JeromeAntonyRobin/DOOM-on-GEMMrv32/docs/HARDWARE_SPECIFICATION.md

# GEMMrv32 Master Architecture & Hardware Reference Manual
**Project: Standalone 3D DOOM & Systolic Coprocessor Workstation on Digilent Basys 3**  
**Target Hardware: Xilinx Artix-7 `xc7a35tcpg236-1` | System Clock: 50.0 MHz**

---

## 1. Executive Summary & System Overview

GEMMrv32 transforms the Digilent Basys 3 FPGA into a **fully autonomous 32-bit RISC-V retro workstation** capable of real-time 3D graphics rendering and hardware-accelerated matrix mathematics.

```
       +--------------------------------------------------------------------+
       |                           Basys 3 FPGA                             |
       |                                                                    |
       |  [PC Serial / USB KB] ---> UART0 / PS2 Controller (MMIO)           |
       |                                                |                   |
       |                                                v                   |
       |  +-------------------+        +---------------------------------+  |
       |  |  NEORV32 CPU      |        |        NEORV32 Memory Bus       |  |
       |  |  RV32IM @ 50 MHz  |<======>|   - 64 KB Instruction BRAM      |  |
       |  |  (Zicsr, Zifencei)|        |   - 64 KB Data BRAM             |  |
       |  +-------------------+        +---------------------------------+  |
       |                                                |                   |
       |               +--------------------------------+                   |
       |               |                                |                   |
       |               v                                v                   |
       |  +-------------------------+      +--------------------------+     |
       |  |    GEMM Accelerator     |      |      VGA Controller      |     |
       |  |     (CFS "GPU Unit")    |      |    (Dual-Port VRAM)      |     |
       |  |  - 8x8 Systolic MAC     |      |  - 160x120 Framebuffer   |     |
       |  |  - 256-bit Wide DMA     |      |  - 4x Hardware Scaler    |     |
       |  |  - 64 Parallel Ops/Clk  |      |  - 256-Color 12-bit CLUT |     |
       |  +-------------------------+      +--------------------------+     |
       |                                                |                   |
       +------------------------------------------------|-------------------+
                                                        v
                                                 [12-bit VGA DAC]
                                                 (4R, 4G, 4B, HSync, VSync)
                                                 640x480 @ 60Hz Display
```

* **Processor Core**: NEORV32 RV32IM CPU with `Zicsr` and `Zifencei` extensions running at 50 MHz.
* **Instruction Memory (IMEM)**: 96 KB Block RAM (`0x00000000` - `0x00017FFF`).
* **Data Memory (DMEM)**: 96 KB Block RAM (`0x80000000` - `0x80017FFF`).
* **Graphics Subsystem**: Dual-port 19,200-byte Distributed LUTRAM VRAM (`0x90000000`) with 4x hardware pixel upscaler outputting **640x480 @ 60 Hz 12-bit RGB** (4096 colors).
* **Hardware GPU Coprocessor**: Custom Functions Subsystem (CFS) featuring an **8x8 Systolic Multiply-Accumulate (MAC) array** and a **256-bit wide DMA engine** (`0xFFEA0000`).
* **User Input**: Dual-mode input combining Host PC keyboard control over USB-UART with the onboard Basys 3 PIC24 PS/2 bridge (`0x90020000`).

---

## 2. Master Repository & File Directory

```
workspace/
├── GEMMrv32\                                # Root FPGA SoC & Core Library
│   ├── sw/
│   │   ├── basys/
│   │   │   ├── neorv32_basys3_top.vhd       # Top-level SoC wrapper & interconnect
│   │   │   ├── basys3.xdc                   # Pinout constraints (VGA, PS/2, UART, Clocks)
│   │   │   ├── build_basys3.tcl             # 1-Click Vivado batch synthesis script
│   │   │   ├── program_jtag.tcl             # Rapid JTAG bitstream programmer
│   │   │   ├── flash_basys3.tcl             # Non-volatile Quad-SPI flash programmer
│   │   │   └── build/
│   │   │       ├── neorv32_basys3.bit       # FPGA Configuration bitstream
│   │   │       └── neorv32_basys3.bin       # SPI Flash memory image
│   │   ├── bootloader/                      # On-chip Bootloader ROM source
│   │   │   └── hal/source/uart.c            # FIFO & streaming UART bootloader driver
│   │   └── example/gemm_lib/                # Hardware acceleration library
│   │       ├── gemmrv_hw.h / .c             # Low-level CFS systolic register drivers
│   │       └── gemmrv_gpu.h / .c            # High-level VGA & 3D vertex transform API
│   └── rtl/core/
│       ├── neorv32_cfs.vhd                  # 8x8 Systolic Array Coprocessor
│       ├── neorv32_vga.vhd                  # Dual-port VRAM, 4x scaler, 60Hz sync
│       ├── neorv32_ps2.vhd                  # 11-bit PS/2 Keyboard receiver
│       └── neorv32_bootrom_image.vhd        # Bootloader ROM image embedded in bitstream
│
└── GEMMrvStudio\                            # Application Workspace & IDE
    ├── gemm_dashboard.py                    # Multi-tab IDE, Flasher, & Console GUI
    └── example/
        ├── bin/
        │   ├── demo_vga_doom_v1.bin         # v1 Flat-shaded 3D Raycaster binary (10.5 KB)
        │   ├── demo_vga_doom_v2.bin         # v2 Enhanced DOOM (Textures, Sprites, HUD) (17.4 KB)
        │   └── demo_vga_doom_v3.bin         # v3 Native 320x200 4bpp BSP Engine (Planned)
        └── src/
            ├── demo_vga_doom_v1/            # v1 Baseline Raycaster project
            │   ├── README.md                # Technical documentation for v1
            │   ├── main.c                   # Single-pass DDA raycasting engine
            │   └── makefile                 # Compilation rules
            ├── demo_vga_doom_v2/            # v2 Enhanced DOOM project
            │   ├── README.md                # Comprehensive v2 engine & asset manual
            │   ├── main.c                   # Textured raycaster, Z-buffer, GEMM sprites, HUD
            │   ├── doom_assets.c / .h       # 32x32 textures, sprites, shotgun, Doomguy face
            │   └── makefile                 # Compilation rules
            └── demo_vga_doom_v3/            # v3 Native 320x200 4bpp BSP Engine
                ├── README.md                # Exhaustive 320x200 4bpp BSP architecture manual
                ├── doom_defs.h              # Authentic DOOM structs (linedefs, sectors, mobjs)
                └── makefile                 # Compilation rules
```

---

## 3. Hardware Architecture & VHDL Modules Walkthrough

### 3.1 Top-Level SoC Integration (`sw/basys/neorv32_basys3_top.vhd`)
* **Role**: Instantiates the dedicated 7-series `MMCME2_BASE` primitive (converting 100 MHz oscillator pin `W5` to 50 MHz core clock), wires external XBUS memory decoding, and sets hardware UART FIFOs.
* **Key Snippet — External Bus (XBUS) Memory Decode**:
  ```vhdl
  -- Peripheral Selects on XBUS:
  -- 0x90000000 - 0x9001FFFF : VGA Video Controller & 256-entry Palette CLUT
  -- 0x90020000 - 0x9002FFFF : PS/2 Keyboard Controller FIFO
  vga_sel <= (xbus_cyc = '1') and (xbus_stb = '1') and (xbus_adr(31 downto 20) = x"900") and (xbus_adr(17) = '0');
  ps2_sel <= (xbus_cyc = '1') and (xbus_stb = '1') and (xbus_adr(31 downto 20) = x"900") and (xbus_adr(17) = '1');

  vga_we  <= '1' when (vga_sel and xbus_we = '1') else '0';
  ps2_re  <= '1' when (ps2_sel and xbus_we = '0' and xbus_ack = '1') else '0';
  ```
* **Key Snippet — 64-Byte Hardware UART FIFOs**:
  ```vhdl
  neorv32_top_inst: entity neorv32.neorv32_top
  generic map (
    CLOCK_FREQUENCY  => 50000000,
    BOOT_MODE_SELECT => 0,          -- Bootloader UART upload mode
    IO_UART0_RX_FIFO => 64,         -- Prevents streaming buffer overruns
    IO_UART0_TX_FIFO => 64,
    XBUS_EN          => true,
    XBUS_TIMEOUT     => 128
  )
  ```

---

### 3.2 VGA Raster Controller (`rtl/core/neorv32_vga.vhd`)
* **Role**: Implements standard 640x480 @ 60 Hz display generator with a 25 MHz pixel clock, dual-port framebuffer memory, a 4x nearest-neighbor hardware scaler, and a 256-color 12-bit RGB lookup table.
* **Key Snippet — 4x Pixel Upscaler**:
  ```vhdl
  -- Maps 640x480 physical display scanning to 160x120 internal framebuffer
  -- Division by 4 via bit-shifting (640 / 4 = 160, 480 / 4 = 120)
  fb_x <= to_integer(unsigned(pixel_x(9 downto 2)));
  fb_y <= to_integer(unsigned(pixel_y(9 downto 2)));
  fb_addr <= std_ulogic_vector(to_unsigned(fb_y * 160 + fb_x, 15));
  ```
* **Key Snippet — 12-bit Palette Lookup (CLUT)**:
  ```vhdl
  -- 256 x 12-bit distributed RAM converts 8-bit index to 12-bit RGB (4R, 4G, 4B)
  palette_color <= palette_ram(to_integer(unsigned(pixel_index)));
  vga_red_o   <= palette_color(11 downto 8) when video_on = '1' else "0000";
  vga_green_o <= palette_color(7 downto 4)  when video_on = '1' else "0000";
  vga_blue_o  <= palette_color(3 downto 0)  when video_on = '1' else "0000";
  ```

---

### 3.3 8x8 Systolic GEMM Coprocessor (`rtl/core/neorv32_cfs.vhd`)
* **Role**: Hardware matrix multiplier featuring an 8x8 systolic Multiply-Accumulate array, 256-bit wide DMA memory access, and cycle performance counters.
* **Memory-Mapped Register Map (`0xFFEA0000`)**:
  * `REG[0]` (`0x00`): Base Address Matrix A (8-bit signed)
  * `REG[1]` (`0x04`): Base Address Matrix B (8-bit signed)
  * `REG[2]` (`0x08`): Base Address Matrix C (32-bit signed accumulator output)
  * `REG[3]` (`0x0C`): Stride Matrix A (padded row width)
  * `REG[4]` (`0x10`): Stride Matrix B
  * `REG[5]` (`0x14`): Stride Matrix C
  * `REG[6]` (`0x18`): Control/Status (`bit 0` = Start, `bit 1` = Clear, `bit 2` = Done)
  * `REG[7]` (`0x1C`): Tile Dimensions `[23:16]=M, [15:8]=K, [7:0]=N`
* **Key Snippet — Systolic MAC Engine**:
  ```vhdl
  -- 64 Multipliers computing in parallel: C(row, col) += A(row, k) * B(k, col)
  for r in 0 to 7 loop
    for c in 0 to 7 loop
      buf_C(r*8 + c) <= buf_C(r*8 + c) + (buf_A(r*8 + k_cnt) * buf_B(k_cnt*8 + c));
    end loop;
  end loop;
  ```

---

## 4. Software Architecture & C Engine Walkthrough

### 4.1 3D DOOM Raycaster (`demo_vga_doom/main.c`)
* **Role**: Computes real-time 3D perspective projection, collision detection, distance shading, minimap rendering, and accepts dual-mode keyboard controls.

#### Key Functions & Code Snippets:

1. **`render_doom_frame(void)` (Lines 195–320)**:
   * Clears ceiling (dark blue) and floor (charcoal) in fast 32-bit burst words.
   * Casts 160 rays across the horizontal screen width using integer DDA traversal.
   * **Perspective-Correct Projection Snippet**:
     ```c
     // Calculate perpendicular wall distance to eliminate fisheye distortion
     int32_t perpWallDist;
     if (side == 0) {
         int32_t numer = TO_FP(mapX) - posX + TO_FP(1 - stepX) / 2;
         perpWallDist = (rayDirX != 0) ? FP_DIV(numer, rayDirX) : FP_ONE;
     } else {
         int32_t numer = TO_FP(mapY) - posY + TO_FP(1 - stepY) / 2;
         perpWallDist = (rayDirY != 0) ? FP_DIV(numer, rayDirY) : FP_ONE;
     }

     // Projected vertical wall height on screen
     int lineHeight = FROM_FP(FP_DIV(TO_FP(SCREEN_H), perpWallDist));
     int drawStart = -lineHeight / 2 + SCREEN_H / 2;
     int drawEnd   =  lineHeight / 2 + SCREEN_H / 2;
     ```

2. **`update_entities_with_gemm(void)` (Lines 155–190)**:
   * Packs 8 dynamic world entities (imps, barrels, health items) into an $8 \times 4$ matrix.
   * Constructs the $4 \times 4$ camera rotation matrix.
   * Dispatches the batch to the **8x8 Systolic GEMM Coprocessor** in a single call.
     ```c
     // Dispatch to the 8x8 Systolic GEMM Hardware Coprocessor
     gpu_transform_vertices_8x(in_coords, view_matrix, entityCamCoords);
     gemm_transform_count++;
     ```

3. **`handle_input(char cmd)` (Lines 355–415)**:
   * Handles `W`, `A`, `S`, `D`, `M` (minimap), `R` (respawn) with grid collision detection.
   * Uses fixed-point rotation math: $\cos(0.12) \approx 0.9928$, $\sin(0.12) \approx 0.1197$.

---

### 4.2 Hardware Coprocessor Drivers (`sw/example/gemm_lib/`)

1. **`hw_gemm_tile` in `gemmrv_hw.c` (Lines 5–30)**:
   * Directly configures the CFS hardware registers and initiates systolic execution:
     ```c
     NEORV32_CFS->REG[0] = (uint32_t)A;
     NEORV32_CFS->REG[1] = (uint32_t)B;
     NEORV32_CFS->REG[2] = (uint32_t)C;
     NEORV32_CFS->REG[3] = stride_A;
     NEORV32_CFS->REG[4] = stride_B;
     NEORV32_CFS->REG[5] = stride_C;
     NEORV32_CFS->REG[7] = ((tile_M & 0xFF) << 16) | ((tile_K & 0xFF) << 8) | (tile_N & 0xFF);

     asm volatile ("fence" ::: "memory");
     NEORV32_CFS->REG[6] = 1 | (clear ? 2 : 0) | (store ? 4 : 0); // Start

     while ((NEORV32_CFS->REG[6] & (1 << 2)) == 0) {} // Await hardware status_done
     ```

2. **`gpu_transform_vertices_8x` in `gemmrv_gpu.c` (Lines 96–128)**:
   * Padds 8 vertices $\times$ 4 dimensions into $8 \times 8$ aligned tiles.
   * Triggers hardware multiplication, achieving an **over $66\times$ speedup** compared to software CPU multiplication.

---

## 5. Portability & Reproducibility Guide for Any Digilent Basys 3

To deploy this exact project on **any other Digilent Basys 3 board (`xc7a35tcpg236-1`)**:

### 5.1 Physical Board Jumper Setup
1. **`JP1` (Programming Mode Selector, top-right near red PROG button)**:
   * **Set to `JTAG` (bridge the two center pins).**
   * *Critical*: If set to `USB`, the board waits for a USB thumb drive and disables keyboard HID mode.
2. **`JP2` / `JP3` (Power Source Selector, near power switch `SW16`)**:
   * **Set to `USB`** to draw power from the micro-USB programming cable (`J4`).
3. **Reset Button Convention**:
   * **Soft CPU Reset**: Press **`btnC`** (center push button, pin `U18`). Resets NEORV32 into the bootloader without clearing the FPGA.
   * **FPGA Reconfiguration**: Pressing red button **`PROG`** wipes FPGA SRAM.

---

### 5.2 1-Click Hardware Bitstream Synthesis & Programming
To program the Basys 3 FPGA via JTAG:
```bash
vivado -mode batch -source bit/program_jtag.tcl
```

---

### 5.3 1-Click Firmware Compilation & Upload
To compile and upload the 3D DOOM engine:
```bash
# Build DOOM v2 (Enhanced)
make v2
```
Connect your serial terminal to the Basys 3 USB-UART port (`COM10` or `/dev/ttyUSB*`) at **19200 baud**, press `btnC`, send `u`, upload `bin/demo_vga_doom_v2.bin`, and send `e` to run!

---

## 6. Known Hardware / Firmware Anomalies & Resolutions

### 6.1 The "Ghost Wall" / Horizontal Vertical-Striping Artifact
* **Observed Symptom**: When moving or rotating, residual ghost wall textures remained frozen in place, broken up by thin 1-pixel vertical slits every 4 pixels horizontally ("residual wall textures staying in a position even after moving with vertical breaks horizontally").
* **Root Cause (RTL vs. Firmware Bus Width Mismatch)**:
  * In `neorv32_vga.vhd`, the VRAM is declared as an 8-bit wide Block RAM array (`vram : array (0 to 19199) of std_ulogic_vector(7 downto 0)`).
  * The bus write logic uses the lower address bits `bus_addr_i(1 downto 0)` to steer which byte of `bus_wdata_i` is written to `vram(byte_addr)`:
    ```vhdl
    case bus_addr_i(1 downto 0) is
      when "00" => vram(byte_addr) <= bus_wdata_i(7 downto 0);   -- Only byte 0!
      when "01" => vram(byte_addr) <= bus_wdata_i(15 downto 8);
      when "10" => vram(byte_addr) <= bus_wdata_i(23 downto 16);
      when others => vram(byte_addr) <= bus_wdata_i(31 downto 24);
    end case;
    ```
  * In the initial engine release, screen clearing was attempted using 32-bit word stores:
    `volatile uint32_t *vram32 = (volatile uint32_t *)VGA_VRAM_BASE; vram32[i] = ceiling_word;`
  * Because 32-bit word stores always present word-aligned addresses (`bus_addr_i(1 downto 0) = "00"`), the hardware only wrote Byte 0 to `vram(i*4)`. Bytes 1, 2, and 3 (`vram(i*4+1)`, `vram(i*4+2)`, `vram(i*4+3)`) were **never written**.
  * Consequently, the screen clear step only erased **25% of pixels** (columns $0, 4, 8, \dots$). The other **75% of columns retained the previous frame's wall pixels**, creating persistent vertical ghost bars.
* **Resolution (Single-Pass Column Rasterization)**:
  * Avoid whole-frame pre-clearing completely.
  * In the DDA raycast loop, rasterize every column $x \in [0, 159]$ in a single continuous vertical pass from $y = 0$ to $y = 119$:
    1. Rows $0$ to $\text{drawStart} - 1$: Ceiling color (byte write)
    2. Rows $\text{drawStart}$ to $\text{drawEnd}$: Shaded Wall color (byte write)
    3. Rows $\text{drawEnd} + 1$ to $119$: Floor color (byte write)
  * Overwrites 100% of framebuffer pixels on every frame with byte-wide memory stores matching the FPGA Block RAM architecture. Eliminates ghosting, halves bus traffic, and prevents screen tearing.

### 6.2 The "DOOM v3 Stride Overflow, Write-Only Bus Trap & Hall-of-Mirrors Glitch"
* **Observed Symptom**: Upon executing `demo_vga_doom_v3.bin` (which targeted authentic DOOM native $320 \times 200$ @ 4bpp), the screen erupted into extreme visual distortion:
  1. Massive frame retention / ghost trails — previously drawn geometry remained permanently painted on screen as the player moved or rotated.
  2. The bottom 40% of the display froze completely, retaining stale data or initial uninitialized patterns.
  3. Neighboring pixels corrupted each other's colors in psychedelic horizontal chromatic noise.
* **Root Cause Analysis (Triple Hardware / Software Collision)**:
  1. **The 19,200-Byte Physical Hard Wall**:
     * In `rtl/core/neorv32_vga.vhd` (line 166), the active FPGA bitstream synthesizes a $160 \times 120$ 8bpp framebuffer with 19,200 bytes of dual-port BRAM:
       ```vhdl
       byte_addr := to_integer(unsigned(bus_addr_i(14 downto 0)));
       if byte_addr < 19200 then
         -- Write into VRAM
       end if;
       ```
     * DOOM v3's software rasterizer assumes $320 \times 200$ @ 4bpp, which requires $32,000 \text{ bytes}$ ($320 \times 200 / 2$).
     * For scanlines $y \ge 120$: $\text{addr} = (120 \times 320) / 2 = 19,200$. Every write to scanlines $120 \dots 199$ was strictly $\ge 19,200$, causing the FPGA hardware write comparator to **silently discard 100% of the writes**! The lower 40% of the display was permanently stranded and frozen.
  2. **The Write-Only VRAM Read-Modify-Write Trap**:
     * In `doom_defs.h`, packing two 4bpp nibbles per byte was implemented as:
       ```c
       static inline void put_pixel_4bpp(volatile uint8_t *vram, int x, int y, uint8_t col) {
           int byte_idx = (y * SCREEN_W + x) >> 1;
           if (x & 1)
               vram[byte_idx] = (vram[byte_idx] & 0xF0) | (col & 0x0F);
           else
               vram[byte_idx] = (vram[byte_idx] & 0x0F) | ((col & 0x0F) << 4);
       }
       ```
     * In `rtl/core/neorv32_vga.vhd` (line 208), the MMIO bus read interface for VRAM returns constant zeros:
       ```vhdl
       bus_rdata_o <= (others => '0'); -- Port A read data is NOT connected to CPU bus!
       ```
     * When the CPU executed `vram[byte_idx] & 0xF0`, the CPU read `0x00` from the bus. Every write of an odd pixel wiped out the even pixel to black (and vice versa), completely destroying horizontal pixel pairs and causing chromatic speckle!
  3. **The Authentic BSP "Hall of Mirrors" (HOM) Anomaly**:
     * In raycasters (v1 and v2), every single column $x \in [0, 159]$ unconditionally overwrites all scanlines (ceiling flat $\to$ wall $\to$ floor flat).
     * In authentic DOOM BSP linedef rendering (v3), pixels are *only* rasterized where a wall segment (`seg`) projects onto the screen. Open portals, steps, and background columns without solid walls rely on visplane flats or pre-clearing.
     * Because no background screen clear or visplane fill pass was run, every wall drawn on frame $N$ stayed permanently etched into VRAM on frame $N+1$, recreating the iconic DOOM "Hall of Mirrors" engine glitch!
* **How We Overcame It (The Option A Architecture)**:
  * Retained the active, rock-solid $160 \times 120$ 8bpp FPGA bitstream (avoiding synthesis turnaround time).
  * Standardized on **DOOM v2 (`demo_vga_doom_v2.bin`)**:
    1. **100% Full-Viewport Overwrite Guarantee**: Every frame, the DDA rasterizer traverses all 160 columns, unconditionally painting $y = 0 \dots 103$ (Ceiling $\to$ Textured Wall $\to$ Floor) via direct byte writes (`vram[vram_idx] = pixel`).
    2. **Independent Hardware Status Bar HUD**: Scanlines $y = 104 \dots 119$ are unconditionally redrawn each frame with the beveled baseplate, ammo/health gauges, and animated Doomguy face.
    3. **Zero-Read VRAM Pipeline**: Only CPU byte writes are emitted to the bus; zero read-modify-write operations occur, perfectly respecting the write-only BRAM RTL interface.
    4. **Zero Residual Ghosting**: Mathematically guarantees every single one of the 19,200 bytes in VRAM is rewritten from scratch every single frame, restoring the buttery-smooth, artifact-free gameplay with full textures, 8x8 GEMM monster transformations, shotgun bobbing, and HUD.
