JeromeAntonyRobin/DOOM-on-GEMMrv32/docs/FRAME_RETENTION_AND_BUFFER_STALL_RESOLUTION.md

# Zero-Retention Column Rasterization & Buffer Stall Resolution

## 1. Executive Summary

During testing of the native $320 \times 200$ Mode 13h bare-metal DOOM 2 port on the Digilent Basys 3 FPGA (`xc7a35t`), severe frame retention, weapon ghosting, frozen muzzle flashes, and buffer stalls were observed.

This report documents the root cause analysis, the architectural solution implemented in the renderer, and the live hardware verification confirming continuous, fluid, zero-retention gameplay.

---

## 2. Root Cause Analysis

Four distinct hardware/software interactions combined to create the perceived frame retention and buffer issues:

### 2.1 The Blocking UART Trap (`neorv32_uart0_available`)
In `main.c`, the main game loop polled keyboard commands using:
```c
if (neorv32_uart0_available()) {
    char cmd = (char)neorv32_uart0_getc();
    handle_input(cmd);
}
```
In the NEORV32 software runtime (`sw/lib/source/neorv32_uart.c`):
- `neorv32_uart_available()` checks if the UART peripheral was **synthesized into the SoC netlist** (`SYSINFO_SOC_IO_UART0`). It returns `1` permanently.
- `neorv32_uart_getc()` is explicitly **blocking**:
  ```c
  char neorv32_uart_getc(neorv32_uart_t *UARTx) {
      while (neorv32_uart_char_received(UARTx) == 0); // wait until data available
      return neorv32_uart_char_received_get(UARTx);
  }
  ```
Because `neorv32_uart0_available()` was always true, `neorv32_uart0_getc()` was invoked on every single frame, **blocking CPU execution indefinitely until the user pressed a key**. The engine was completely frozen when idle, rendering only 1 frame per keystroke and retaining old frames permanently.

### 2.2 VRAM 32-Bit Word Store Truncation
In `rtl/core/neorv32_vga.vhd` (line 220), the dual-port Block RAM write interface is byte-wide:
```vhdl
if bus_we_i = '1' and bus_addr_i(16) = '0' then
    byte_addr_w := to_integer(unsigned(bus_addr_i(15 downto 0)));
    if byte_addr_w < 64000 then
        case bus_addr_i(1 downto 0) is
            when "00"   => vram(byte_addr_w) <= bus_wdata_i(7 downto 0);
            when "01"   => vram(byte_addr_w) <= bus_wdata_i(15 downto 8);
            when "10"   => vram(byte_addr_w) <= bus_wdata_i(23 downto 16);
            when others => vram(byte_addr_w) <= bus_wdata_i(31 downto 24);
        end case;
    end if;
end if;
```
Any 32-bit word store (`sw` instruction or standard `memset`) writes only to `bus_addr_i(1..0) == "00"`, **dropping 3 out of every 4 bytes**. When earlier attempts tried to clear the screen using 32-bit word stores, 75% of pixel columns were never wiped, creating comb-like retention artifacts.

### 2.3 Phantom VBlank Spin Delay
`wait_for_vblank()` polled `VGA_STATUS_REG` (`0x90010400`). On the XC7A35T single-buffered bitstream, sampling `0x90010400` 100,000 times returned `0x00000000` constantly. The timeout loop was spinning for 500,000 cycles (~110 ms) on every single frame, artificially throttling the engine down to 8 FPS and causing huge stutter gaps.

### 2.4 Unoccluded Column Apertures
In single-buffered Mode 13h without a double buffer, clearing the entire 53,760-byte viewport at the start of a frame causes severe flicker because the VGA raster beam scans the memory while it is blank. Conversely, without clearing, columns that do not intersect a solid wall retained previous frame pixels (such as moving Imps, bobbing weapons, or muzzle flashes).

---

## 3. The Solution: Zero-Retention 100% Column Rasterization

To eliminate both frame retention and buffer flicker without requiring a double buffer (which cannot fit in the Basys 3's 50 BRAM tiles), the Id Software single-pass column coverage model was implemented:

```
+-------------------------------------------------------------+
| Viewport Scanlines (y = 0 .. 167)                           |
|                                                             |
|   1. R_RenderBSPNode(0)                                     |
|      - One-sided solid walls: draws ceiling, STARTAN3, floor|
|      - Two-sided portals: draws steps, updates clip arrays  |
|                                                             |
|   2. R_FillBackdrop()                                       |
|      - For any column x with ceilingclip[x] < floorclip[x]: |
|        * y = ceilingclip[x]+1 .. 83: Tech Blue Ceiling (112)|
|        * y = 84 .. floorclip[x]-1: Stone Floor Flat (72)    |
|      ==> 100% OF ALL 53,760 VIEWPORT PIXELS OVERWRITTEN!    |
|                                                             |
|   3. R_DrawMasked() (Imps, Barrels, Fireballs via GEMM)     |
|   4. render_weapon() (Super Shotgun + dynamic muzzle flash) |
+-------------------------------------------------------------+
| Status Bar Scanlines (y = 168 .. 199)                       |
|   5. render_status_bar()                                    |
|      - Grey bevel plate, Doomguy face, Ammo bar, Health bar |
|      ==> 100% OF ALL 10,240 HUD PIXELS OVERWRITTEN!         |
+-------------------------------------------------------------+
```

### 3.1 `R_FillBackdrop()` Implementation (`src/v4/r_segs.c`)
```c
void R_FillBackdrop(void) {
    volatile uint8_t *vram = (volatile uint8_t *)VGA_VRAM_BASE;

    for (int x = 0; x < SCREEN_W; x++) {
        int c_top = ceilingclip[x];
        int f_bot = floorclip[x];

        if (c_top < f_bot) {
            // Fill unoccluded ceiling above horizon (CENTER_Y = 84)
            int y_end_ceil = (f_bot < CENTER_Y) ? f_bot : CENTER_Y;
            for (int y = c_top + 1; y < y_end_ceil; y++) {
                vram[y * SCREEN_W + x] = 112; // Authentic tech blue ceiling
            }

            // Fill unoccluded floor below horizon down to f_bot
            int y_start_floor = (c_top + 1 > CENTER_Y) ? (c_top + 1) : CENTER_Y;
            for (int y = y_start_floor; y < f_bot; y++) {
                vram[y * SCREEN_W + x] = 72;  // Authentic brown stone floor flat
            }
        }
    }
}
```

### 3.2 Non-Blocking Input Loop (`src/v4/main.c`)
```c
while (1) {
    // Poll UART0 (PC Keyboard) - Non-blocking FIFO check!
    if (neorv32_uart0_char_received()) {
        char cmd = neorv32_uart0_char_received_get();
        handle_input(cmd);
    }

    // Poll PS/2 Keyboard Port - Non-blocking!
    if (*((volatile uint32_t *)PS2_STAT_REG) & 1) {
        uint8_t sc = (uint8_t)(*((volatile uint32_t *)PS2_DATA_REG) & 0xFF);
        char ch = ps2_scancode_to_ascii(sc);
        if (ch) handle_input(ch);
    }

    // Advance 35 Hz Monster AI & Projectile physics
    P_Ticker();

    // Render Frame continuously for fluid, retention-free gameplay
    render_doom_v3_frame();
    if (muzzle_flash > 0) muzzle_flash--;
}
```

---

## 4. Hardware Verification & Results

1. **Continuous Autonomy**: The engine was flashed to Digilent Basys 3 over `COM10` at 19,200 baud. The main loop ran uninterrupted, advancing beyond Frame 250 with continuous real-time telemetry streaming.
2. **Zero Retention**: Moving the camera (`w`, `s`, `a`, `d`), weapon bobbing, and firing the Super Shotgun (`SPACE`) confirmed:
   - Zero ghosting behind walking Imps.
   - Zero lingering buckshot or muzzle flash pixels.
   - Clean Doomguy face updates on the status bar.
3. **GEMM Coprocessor Utilization**: 1:1 hardware batch processing across all rendered frames without stalling.
