JeromeAntonyRobin/DOOM-on-GEMMrv32/sw/basys/clockInfo.txt

-------------------------------------
| Tool Version : Vivado v.2025.2
| Date         : Wed Oct 14 12:19:21 2026
| Host         : Eathes
| Design       : design_1
| Device       : xc7a35t-cpg236-1--
-------------------------------------

For more information on clockInfo.txt clock routing debug file see https://support.xilinx.com/s/article/000035660?language=en_US
