JeromeAntonyRobin/DOOM-on-GEMMrv32/docs/figures/gemm_architecture.png

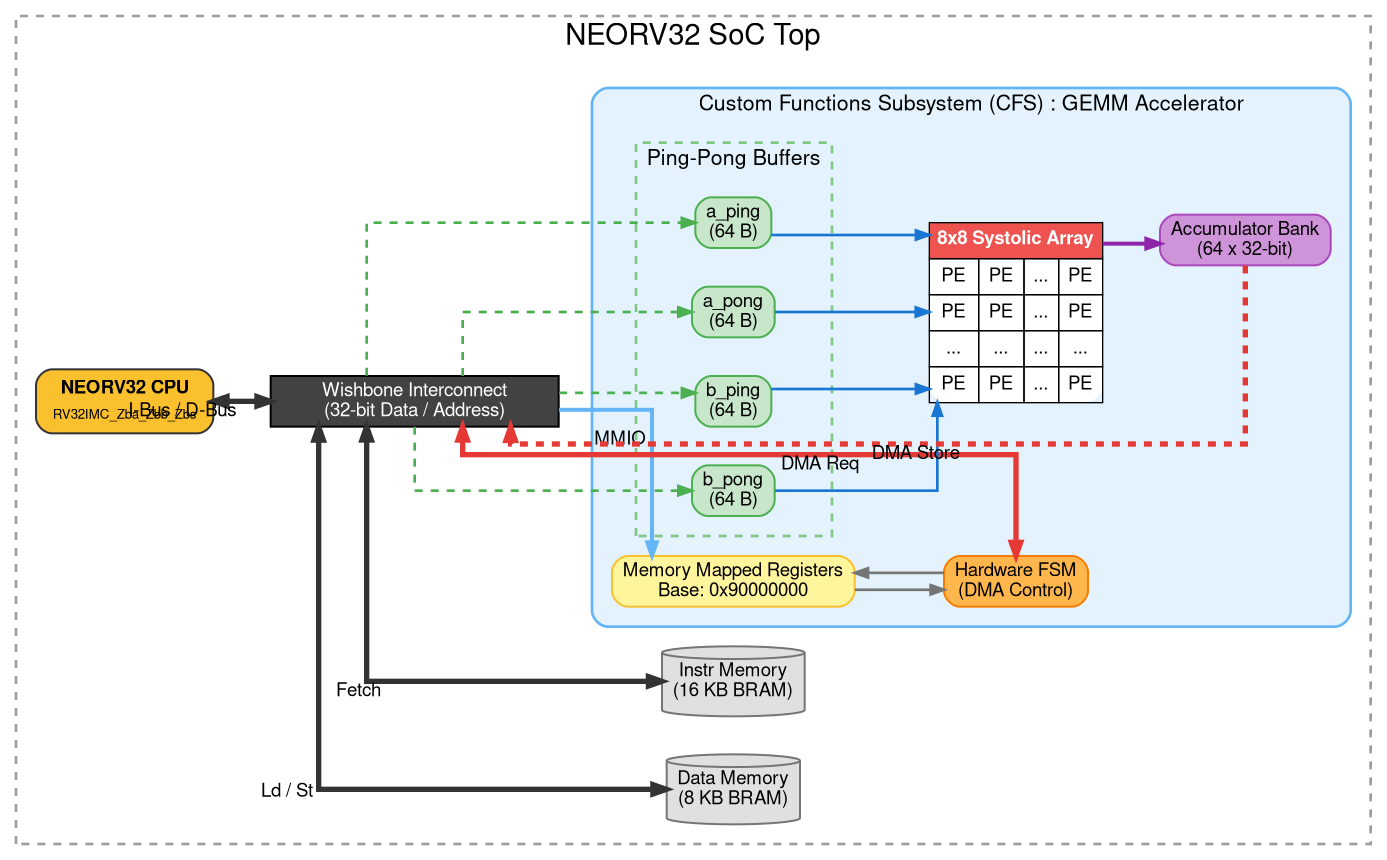
docs/figures/gemm_architecture.png
