JeromeAntonyRobin/DOOM-on-GEMMrv32/docs/AUTHENTIC_RENDERING_PIPELINE_FIXES.md

# Authentic DOOM 2 Rendering Pipeline Resolution on GEMMrv32

## Executive Summary
This document records the comprehensive architectural investigation and fixes implemented to eliminate visual rendering issues in the bare-metal authentic DOOM 2 engine running on the Digilent Basys 3 FPGA (`xc7a35t`).

The engine runs at **native 320x200 @ 8bpp Mode 13h** using an on-chip Block RAM single framebuffer and an authentic 256-color 12-bit RGB palette extracted directly from Id Software's `DOOM2.WAD`.

---

## 1. Root Cause Analyses & Technical Solutions

### 1.1 The Two-Sided Portal Floor Retention Gap
- **Symptom**: Massive frame retention, sprite trails, and frozen weapon ghosts across the bottom-center scanlines ($y = 117..167$) when facing doorways or stairs.
- **Root Cause**:
  In `r_segs.c`, two-sided portals (such as the stair step on Line 2) rasterized only the step face and adjusted `floorclip[x] = y_b_floor`. When distant solid walls (such as the courtyard wall on Line 6) were subsequently rasterized, they only drew pixels up to `floorclip[x]` and then set `floorclip[x] = -1` to mark the column occluded. The floor area in front of the step ($y = 117..167$) was **never drawn** by the portal, **never drawn** by the distant wall, and skipped by post-backdrop fill logic because `floorclip[x]` was $-1$. Consequently, any pixels written by the weapon sprite or walking monsters in that aperture remained permanently in VRAM.
- **Solution**:
  Implemented `R_ClearBackdrop()`, which performs a fast linear fill of the top 84 lines with authentic tech blue ceiling flat (index `112`) and the bottom 84 lines with brown stone floor flat (index `72`) before any geometry traversal. This guarantees 100% clean background pixel coverage every frame without requiring a black pre-wipe.

### 1.2 BSP Subsector Traversal Line Decoupling
- **Symptom**: Inverted occlusion where far walls overwrote near walls depending on player angle, coupled with quadruple rendering overhead.
- **Root Cause**:
  `R_Subsector(num)` in `r_bsp.c` previously looped across all linedefs in the map regardless of `num`. Every subsector traversed by the recursive BSP walk re-evaluated all linedefs in fixed array index order ($0..11$), bypassing BSP front-to-back sorting and wasting CPU time.
- **Solution**:
  Defined explicit subsector linedef partitions:
  - Subsector 0 (Starting Hangar): Lines `{0, 1, 2}`
  - Subsector 1 (Stairs & West Courtyard): Lines `{3, 5, 6, 7}`
  - Subsector 2 (Stairs & East Courtyard): Lines `{4, 5, 7, 8}`
  - Subsector 3 (Computer Terminal Room): Lines `{9, 10, 11}`
  Integrated a per-frame `line_rendered[NUM_LINES]` bitmask reset by `R_ClearClipSegs()`. Lines are now rasterized strictly in true front-to-back order, with zero redundant processing.

### 1.3 Open Portal Depth Occlusion of Monsters
- **Symptom**: Imp demons standing in the stairway or courtyard were either completely invisible or sliced in half.
- **Root Cause**:
  In `r_segs.c`, two-sided walls were updating `wall_dist_buffer[x] = tz`. Because `wall_dist_buffer` is a 1D column buffer, storing the portal's distance caused `R_DrawMasked()` to treat the open doorway as an opaque wall, rejecting any monster positioned behind the doorway.
- **Solution**:
  Updated two-sided portal logic to never overwrite `wall_dist_buffer[x]`. Only solid, one-sided walls write to `wall_dist_buffer[x]`, allowing monsters in adjacent rooms to remain fully visible through doorways.

### 1.4 Gap-Free Sprite Scaler Precision & Bounds
- **Symptom**: Monster billboards exhibited horizontal scanline gaps ("Venetian-blind" effect) and occasional CPU hangs when walking close to enemies.
- **Root Cause**:
  `draw_authentic_patch_scaled()` in `doom_assets_authentic.c` clamped `dest_y0` and `dest_y1` to screen bounds *before* computing the denominator `post_h = dest_y1 - dest_y0`. When an entity was clipped by the viewport edge, `post_h` shrank, accelerating texture sampling and causing divide-by-zero or out-of-bounds reads.
- **Solution**:
  Calculated `raw_post_h = raw_dest_y1 - raw_dest_y0` using unclamped projections. Enforced `raw_post_h > 0` before clamping screen bounds `dest_y0` and `dest_y1`, and continuously interpolated scanlines via `((dy - raw_dest_y0) * length) / raw_post_h`.

### 1.5 Authentic DOOM 2 Monster Spawning
- **Symptom**: Barrels and medkits appeared as squished Imp demon sprites.
- **Root Cause**:
  `R_DrawMasked()` defaulted to `patch_trooa1` for non-monster entities.
- **Solution**:
  Updated `map_spawns` in `doom_map.h` to spawn genuine DOOM 2 enemies with their extracted Id Software WAD patches:
  - Imp Demon (`MT_IMP` with `patch_trooa1`) at the top of the stairs.
  - Pinky Demon (`MT_DEMON` with `patch_sarga1`) roaming the toxic courtyard.
  - Shotgun Guy (`MT_SHOTGUNGUY` with `patch_sposa1`) guarding the computer terminal room.
  Filtered out non-monster types in `p_mobj.c` so only authentic sprites are rendered.

---

## 2. Verification & Live Hardware Status
- **Target Hardware**: Digilent Basys 3 FPGA (`xc7a35t`, target `210183BE9DFDA`).
- **UART Port**: `COM10` @ 19,200 baud.
- **Frame Rate & Stability**: Continuous telemetry verified past 120+ frames (`[DOOM 2] Frame: 120 | GEMM Batches: 120 | Health: 100 | Ammo: 48`).
- **Weapon & AI**: Super Shotgun fires 20 buckshot pellets with twin muzzle flash, inflicting 120 damage and eliminating monsters in real time.
