JeromeAntonyRobin/DOOM-on-GEMMrv32/rtl/core/neorv32_bootrom_image.vhd

library ieee;
use ieee.std_logic_1164.all;

package neorv32_bootrom_image is

type rom_t is array (0 to 2047) of std_ulogic_vector(31 downto 0);
constant image_size_c : natural := 4272;
constant image_data_c : rom_t := (
x"f14020f3",
x"80200217",
x"0fc20213",
x"ff027113",
x"80200197",
x"7f018193",
x"000022b7",
x"80028293",
x"30029073",
x"00000317",
x"13030313",
x"30531073",
x"30401073",
x"00001397",
x"05438393",
x"80200417",
x"fc440413",
x"80200497",
x"fc048493",
x"80200517",
x"fb850513",
x"80200597",
x"fbc58593",
x"00000613",
x"00000693",
x"00000713",
x"00000793",
x"00000813",
x"00000893",
x"00000913",
x"00000993",
x"00000a13",
x"00000a93",
x"00000b13",
x"00000b93",
x"00000c13",
x"00000c93",
x"00000d13",
x"00000d93",
x"00000e13",
x"00000e93",
x"00000f13",
x"00000f93",
x"04008463",
x"00000797",
x"01c78793",
x"30579073",
x"30445073",
x"30046073",
x"10500073",
x"ffdff06f",
x"00000797",
x"08878793",
x"30579073",
x"30405073",
x"fff44737",
x"00872103",
x"00c72603",
x"fff40737",
x"00072223",
x"0380006f",
x"00838e63",
x"00947c63",
x"0003a783",
x"00f42023",
x"00438393",
x"00440413",
x"fe9468e3",
x"00b57863",
x"00052023",
x"00450513",
x"feb56ce3",
x"00000617",
x"79860613",
x"0ff0000f",
x"0000100f",
x"00000513",
x"00000593",
x"000600e7",
x"30047073",
x"30401073",
x"00000597",
x"01058593",
x"30559073",
x"34051073",
x"10500073",
x"ffdff06f",
x"fffe07b7",
x"0087a783",
x"00000513",
x"00e79713",
x"00075e63",
x"fff507b7",
x"0007a703",
x"00f71693",
x"fe06dce3",
x"0047a503",
x"0ff57513",
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
x"01010113",
x"00012d03",
x"00412c83",
x"00812c03",
x"00c12b83",
x"01010113",
x"00012b03",
x"00412a83",
x"00812a03",
x"00c12983",
x"01010113",
x"00012903",
x"00412483",
x"00812403",
x"00c12083",
x"01010113",
x"00008067",
x"52524507",
x"445f524f",
x"43495645",
x"00000a45",
x"00000000",
x"52524507",
x"535f524f",
x"414e4749",
x"45525554",
x"0000000a",
x"52524507",
x"435f524f",
x"4b434548",
x"0a4d5553",
x"00000000",
x"000a4b4f",
x"5b1b070a",
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
x"79ca1a27",
x"740f360c",
x"8051f1ad",
others => (others => '0')
);

end package;
