JeromeAntonyRobin/DOOM-on-GEMMrv32/rtl/core/neorv32_imem_image.vhd

library ieee;
use ieee.std_logic_1164.all;

package neorv32_imem_image is

type rom_t is array (0 to 8191) of std_ulogic_vector(31 downto 0);
constant image_size_c : natural := 32768;
constant image_data_c : rom_t := (
x"f14020f3",
x"80010217",
x"ffc20213",
x"ff027113",
x"80000197",
x"7f018193",
x"000022b7",
x"80028293",
x"30029073",
x"00000317",
x"19430313",
x"30531073",
x"30401073",
x"00001397",
x"f4838393",
x"80000417",
x"fc440413",
x"80000497",
x"fbc48493",
x"80000517",
x"fb450513",
x"80000597",
x"fac58593",
x"00000613",
x"00000693",
x"00000713",
x"00000793",
x"00000813",
x"00000893",
x"00000913",
x"00000993",
x"00000a13",
x"00000a93",
x"00000b13",
x"00000b93",
x"00000c13",
x"00000c93",
x"00000d13",
x"00000d93",
x"00000e13",
x"00000e93",
x"00000f13",
x"00000f93",
x"04008463",
x"00000797",
x"01c78793",
x"30579073",
x"30445073",
x"30046073",
x"10500073",
x"ffdff06f",
x"00000797",
x"0ec78793",
x"30579073",
x"30405073",
x"fff44737",
x"00872103",
x"00c72603",
x"fff40737",
x"00072223",
x"05c0006f",
x"00838e63",
x"00947c63",
x"0003a783",
x"00f42023",
x"00438393",
x"00440413",
x"fe9468e3",
x"00b57863",
x"00052023",
x"00450513",
x"feb56ce3",
x"00001417",
x"b9040413",
x"00001497",
x"b8848493",
x"00947a63",
x"00042083",
x"000080e7",
x"00440413",
x"fe946ae3",
x"00000617",
x"21860613",
x"0ff0000f",
x"0000100f",
x"00000513",
x"00000593",
x"000600e7",
x"30047073",
x"30401073",
x"00000597",
x"05058593",
x"30559073",
x"34051073",
x"f1402473",
x"02041463",
x"00001417",
x"b3040413",
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
x"00000000",
x"00000000",
x"00000000",
x"00000000",
x"00000000",
x"00000000",
x"00000000",
x"00000000",
x"00000000",
x"00000000",
x"00000000",
x"00000000",
x"00000000",
x"00000000",
x"00000000",
x"00000000",
x"00000000",
x"00000000",
x"00000000",
x"00000000",
x"00000000",
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
);

end package;
