JeromeAntonyRobin/DOOM-on-GEMMrv32/rtl/core/neorv32_prim.vhd

-- ================================================================================ --
-- NEORV32 Primitives - Generic Single-Clock FIFO (FIFO)                            --
-- -------------------------------------------------------------------------------- --
-- The FIFO operates in "first-word-fall-through" (FWFT) mode: the first written    --
-- word appears directly at the output (after the optional synchronous-read delay)  --
-- without any explicit read access.                                                --
-- -------------------------------------------------------------------------------- --
-- The NEORV32 RISC-V Processor - https://github.com/stnolting/neorv32              --
-- Copyright (c) NEORV32 contributors.                                              --
-- Copyright (c) 2020 - 2026 Stephan Nolting. All rights reserved.                  --
-- Licensed under the BSD-3-Clause license, see LICENSE for details.                --
-- SPDX-License-Identifier: BSD-3-Clause                                            --
-- ================================================================================ --

library ieee;
use ieee.std_logic_1164.all;
use ieee.numeric_std.all;

entity neorv32_prim_fifo is
  generic (
    AWIDTH  : natural; -- address width (= log2(number of FIFO entries))
    DWIDTH  : natural; -- size of data elements in FIFO
    OUTGATE : boolean; -- true = output zero if no data available
    ASYNCRD : boolean  -- true = asynchronous read, false = synchronous read
  );
  port (
    -- global control --
    clk_i   : in  std_ulogic;                           -- clock, rising edge
    rstn_i  : in  std_ulogic;                           -- async reset, low-active
    clear_i : in  std_ulogic;                           -- sync reset, high-active
    -- write port --
    wdata_i : in  std_ulogic_vector(DWIDTH-1 downto 0); -- write data
    we_i    : in  std_ulogic;                           -- write enable
    free_o  : out std_ulogic;                           -- at least one entry is free when set
    -- read port --
    re_i    : in  std_ulogic;                           -- read enable
    rdata_o : out std_ulogic_vector(DWIDTH-1 downto 0); -- read data
    avail_o : out std_ulogic                            -- data available when set
  );
end entity;

architecture neorv32_prim_fifo_rtl of neorv32_prim_fifo is

  -- memory core; the actual RAM signal is declared per generate-branch as a shared
  -- architecture-scope signal would defeat RAM extraction on some synthesis tools --
  type ram_t is array ((2**AWIDTH)-1 downto 0) of std_ulogic_vector(DWIDTH-1 downto 0);

  -- local signals --
  signal rdata : std_ulogic_vector(DWIDTH-1 downto 0);
  signal we, re, match, full, empty, avail : std_ulogic;
  signal w_pnt, w_nxt, r_pnt, r_nxt : std_ulogic_vector(AWIDTH downto 0);

begin

  -- Pointers -------------------------------------------------------------------------------
  -- -------------------------------------------------------------------------------------------
  pointer_reg: process(rstn_i, clk_i)
  begin
    if (rstn_i = '0') then
      w_pnt <= (others => '0');
      r_pnt <= (others => '0');
    elsif rising_edge(clk_i) then
      w_pnt <= w_nxt;
      r_pnt <= r_nxt;
    end if;
  end process;

  -- access control --
  re <= re_i and (not empty); -- read only if data available
  we <= we_i and (not full);  -- write only if free space available

  -- pointer update --
  w_nxt <= (others => '0') when (clear_i = '1') else std_ulogic_vector(unsigned(w_pnt) + 1) when (we = '1') else w_pnt;
  r_nxt <= (others => '0') when (clear_i = '1') else std_ulogic_vector(unsigned(r_pnt) + 1) when (re = '1') else r_pnt;

  -- Status ---------------------------------------------------------------------------------
  -- -------------------------------------------------------------------------------------------
  -- more than 1 FIFO entry --
  status_large:
  if (AWIDTH > 0) generate
    match <= '1' when (r_pnt(AWIDTH-1 downto 0) = w_pnt(AWIDTH-1 downto 0)) else '0';
    full  <= '1' when (r_pnt(AWIDTH) /= w_pnt(AWIDTH)) and (match = '1') else '0';
    empty <= '1' when (r_pnt(AWIDTH)  = w_pnt(AWIDTH)) and (match = '1') else '0';

    -- synchronous read: "avail" is synchronized to the read port --
    status_large_sync_read:
    if not ASYNCRD generate
      avail_reg: process(clk_i)
      begin
        if rising_edge(clk_i) then
          avail <= not empty;
        end if;
      end process;
    end generate;

    -- asynchronous read --
    status_large_async_read:
    if ASYNCRD generate
      avail <= not empty;
    end generate;

  end generate;

  -- just 1 FIFO entry --
  status_small:
  if (AWIDTH = 0) generate
    match <= '1' when (r_pnt(0) = w_pnt(0)) else '0';
    full  <= not match;
    empty <= not full;
    avail <= not empty;
  end generate;

  -- status output --
  free_o  <= not full;
  avail_o <= avail;


  -- Memory ---------------------------------------------------------------------------------
  -- -------------------------------------------------------------------------------------------
  -- more than 1 FIFO entry --
  memory_large:
  if (AWIDTH > 0) generate

    -- memory with synchronous read --
    memory_large_sync_read:
    if not ASYNCRD generate
      signal fifo : ram_t;
    begin
      memory_core: process(clk_i) -- simple dual-port RAM
      begin
        if rising_edge(clk_i) then
          if (we = '1') then
            fifo(to_integer(unsigned(w_pnt(AWIDTH-1 downto 0)))) <= wdata_i;
          end if;
          rdata <= fifo(to_integer(unsigned(r_pnt(AWIDTH-1 downto 0))));
        end if;
      end process;
    end generate;

    -- memory with asynchronous read --
    memory_large_async_read:
    if ASYNCRD generate
      signal fifo : ram_t;
    begin
      memory_core: process(clk_i) -- simple dual-port RAM
      begin
        if rising_edge(clk_i) then
          if (we = '1') then
            fifo(to_integer(unsigned(w_pnt(AWIDTH-1 downto 0)))) <= wdata_i;
          end if;
        end if;
      end process;
      rdata <= fifo(to_integer(unsigned(r_pnt(AWIDTH-1 downto 0))));
    end generate;

  end generate;

  -- just 1 FIFO entry --
  memory_small:
  if (AWIDTH = 0) generate
    signal fifo : ram_t;
  begin
    memory_core: process(clk_i) -- single register
    begin
      if rising_edge(clk_i) then
        if (we = '1') then
          fifo(0) <= wdata_i;
        end if;
      end if;
    end process;
    rdata <= fifo(0);
  end generate;

  -- output gate: output zero if no data available --
  rdata_o <= (others => '0') when OUTGATE and (avail = '0') else rdata;

end architecture;


-- ================================================================================ --
-- NEORV32 Primitives - Generic Single-Port RAM (SPRAM)                             --
-- -------------------------------------------------------------------------------- --
-- Provides a single read/write port. Read-during-write behavior is irrelevant as   --
-- read and write accesses are guaranteed to be mutually exclusive.                 --
-- -------------------------------------------------------------------------------- --
-- The NEORV32 RISC-V Processor - https://github.com/stnolting/neorv32              --
-- Copyright (c) NEORV32 contributors.                                              --
-- Copyright (c) 2020 - 2026 Stephan Nolting. All rights reserved.                  --
-- Licensed under the BSD-3-Clause license, see LICENSE for details.                --
-- SPDX-License-Identifier: BSD-3-Clause                                            --
-- ================================================================================ --

library ieee;
use ieee.std_logic_1164.all;
use ieee.numeric_std.all;

entity neorv32_prim_spram is
  generic (
    AWIDTH : natural; -- address width (number of bits)
    DWIDTH : natural; -- data width (number of bits)
    OUTREG : boolean  -- add output register stage when true
  );
  port (
    -- global control --
    clk_i  : in  std_ulogic;                           -- clock, rising edge
    -- read/write port --
    en_i   : in  std_ulogic;                           -- access enable
    rw_i   : in  std_ulogic;                           -- 0=read, 1=write
    addr_i : in  std_ulogic_vector(AWIDTH-1 downto 0); -- address
    data_i : in  std_ulogic_vector(DWIDTH-1 downto 0); -- write data
    data_o : out std_ulogic_vector(DWIDTH-1 downto 0)  -- read data
  );
end entity;

architecture neorv32_prim_spram_rtl of neorv32_prim_spram is

  -- memory core; the actual RAM signal is declared per generate-branch as a shared
  -- architecture-scope signal would defeat RAM extraction on some synthesis tools --
  type ram_t is array ((2**AWIDTH)-1 downto 0) of std_ulogic_vector(DWIDTH-1 downto 0);
  signal rdata : std_ulogic_vector(DWIDTH-1 downto 0);

begin

  -- Memory Core ----------------------------------------------------------------------------
  -- -------------------------------------------------------------------------------------------
  memory_large:
  if (AWIDTH > 0) generate
    signal spram : ram_t;
    attribute ram_style : string;
    attribute ram_style of spram : signal is "block";
  begin
    memory_core: process(clk_i)
    begin
      if rising_edge(clk_i) then
        if (en_i = '1') then
          if (rw_i = '1') then
            spram(to_integer(unsigned(addr_i))) <= data_i;
          end if;
          rdata <= spram(to_integer(unsigned(addr_i)));
        end if;
      end if;
    end process;
  end generate;

  -- single entry only --
  memory_small:
  if (AWIDTH = 0) generate
    signal spram : ram_t;
  begin
    memory_core: process(clk_i)
    begin
      if rising_edge(clk_i) then
        if (en_i = '1') and (rw_i = '1') then
          spram(0) <= data_i;
        end if;
      end if;
    end process;
    rdata <= spram(0);
  end generate;

  -- Output Register ------------------------------------------------------------------------
  -- -------------------------------------------------------------------------------------------
  output_register_enabled:
  if OUTREG generate -- might improve FPGA mapping and/or timing results
    read_outreg: process(clk_i)
    begin
      if rising_edge(clk_i) then
        data_o <= rdata;
      end if;
    end process;
  end generate;

  -- no output register --
  output_register_disabled:
  if not OUTREG generate
    data_o <= rdata;
  end generate;

end architecture;


-- ================================================================================ --
-- NEORV32 Primitives - Generic Signed/Unsigned Integer Multiplier (MUL)            --
-- -------------------------------------------------------------------------------- --
-- The result is valid NUM_REGS+1 cycles after en_i.                                --
-- -------------------------------------------------------------------------------- --
-- The NEORV32 RISC-V Processor - https://github.com/stnolting/neorv32              --
-- Copyright (c) NEORV32 contributors.                                              --
-- Copyright (c) 2020 - 2026 Stephan Nolting. All rights reserved.                  --
-- Licensed under the BSD-3-Clause license, see LICENSE for details.                --
-- SPDX-License-Identifier: BSD-3-Clause                                            --
-- ================================================================================ --

library ieee;
use ieee.std_logic_1164.all;
use ieee.numeric_std.all;

entity neorv32_prim_mul is
  generic (
    DWIDTH   : natural;                   -- operand width
    NUM_REGS : natural range 1 to 3 := 1  -- number of multiplier register stages
  );
  port (
    -- global control --
    clk_i  : in  std_ulogic;                              -- clock, rising edge
    -- data path --
    en_i   : in  std_ulogic;                              -- enable input operand registers
    opa_i  : in  std_ulogic_vector(DWIDTH-1 downto 0);    -- operand A
    opas_i : in  std_ulogic;                              -- operand A is a signed number
    opb_i  : in  std_ulogic_vector(DWIDTH-1 downto 0);    -- operand B
    opbs_i : in  std_ulogic;                              -- operand B is a signed number
    res_o  : out std_ulogic_vector((2*DWIDTH)-1 downto 0) -- resulting product
  );
end entity;

architecture neorv32_prim_mul_rtl of neorv32_prim_mul is

  signal opa, opb : signed(DWIDTH downto 0);
  signal res      : signed((2*DWIDTH)+1 downto 0);

begin

  -- Input Registers ------------------------------------------------------------------------
  -- -------------------------------------------------------------------------------------------
  in_reg: process(clk_i)
  begin
    if rising_edge(clk_i) then
      if (en_i = '1') then
        opa <= signed((opa_i(opa_i'left) and opas_i) & opa_i);
        opb <= signed((opb_i(opb_i'left) and opbs_i) & opb_i);
      end if;
    end if;
  end process;

  -- Multiplier -----------------------------------------------------------------------------
  -- -------------------------------------------------------------------------------------------
  one_reg:
  if (NUM_REGS = 1) generate
    mul_reg: process(clk_i)
    begin
      if rising_edge(clk_i) then -- no reset to improve multiplier mapping
        res <= opa * opb;
      end if;
    end process;
  end generate;

  two_regs:
  if (NUM_REGS = 2) generate
    signal mul_res : signed((2*DWIDTH)+1 downto 0);
  begin
    mul_reg: process(clk_i)
    begin
      if rising_edge(clk_i) then -- no reset to improve multiplier mapping
        mul_res <= opa * opb;
      end if;
    end process;

    result_reg: process(clk_i)
    begin
      if rising_edge(clk_i) then -- no reset to improve multiplier mapping
        res <= mul_res;
      end if;
    end process;
  end generate;

  three_regs:
  if (NUM_REGS = 3) generate
    constant lo_width_c : natural := DWIDTH / 2;
    constant hi_width_c : natural := (DWIDTH + 1) - lo_width_c;
    constant pp_width_c : natural := 2 * hi_width_c;
    constant pr_width_c : natural := (2 * DWIDTH) + 2;

    signal q_ll, q_lh, q_hl, q_hh : signed(pp_width_c-1 downto 0);
    signal q_sum_lo, q_sum_hi     : signed(pr_width_c-1 downto 0);
  begin
    partial_product_reg: process(clk_i)
    begin
      if rising_edge(clk_i) then -- no reset to improve multiplier mapping
        q_ll <= resize(signed('0' & std_ulogic_vector(opa(lo_width_c-1 downto 0))) *
                       signed('0' & std_ulogic_vector(opb(lo_width_c-1 downto 0))), pp_width_c);
        q_lh <= resize(signed('0' & std_ulogic_vector(opa(lo_width_c-1 downto 0))) *
                       resize(opb(opb'left downto lo_width_c), hi_width_c), pp_width_c);
        q_hl <= resize(resize(opa(opa'left downto lo_width_c), hi_width_c) *
                       signed('0' & std_ulogic_vector(opb(lo_width_c-1 downto 0))), pp_width_c);
        q_hh <= resize(resize(opa(opa'left downto lo_width_c), hi_width_c) *
                       resize(opb(opb'left downto lo_width_c), hi_width_c), pp_width_c);
      end if;
    end process;

    partial_sum_reg: process(clk_i)
    begin
      if rising_edge(clk_i) then -- no reset to improve multiplier mapping
        q_sum_lo <= resize(q_ll, pr_width_c) + shift_left(resize(q_lh, pr_width_c), lo_width_c);
        q_sum_hi <= shift_left(resize(q_hl, pr_width_c), lo_width_c) +
                    shift_left(resize(q_hh, pr_width_c), 2*lo_width_c);
      end if;
    end process;

    result_reg: process(clk_i)
    begin
      if rising_edge(clk_i) then -- no reset to improve multiplier mapping
        res <= q_sum_lo + q_sum_hi;
      end if;
    end process;
  end generate;

  -- result --
  res_o <= std_ulogic_vector(res((2*DWIDTH)-1 downto 0));

end architecture;


-- ================================================================================ --
-- NEORV32 Primitives - Generic Counter Module                                      --
-- -------------------------------------------------------------------------------- --
-- High and low words are split across two individual registers to improve timing   --
-- by cutting the carry chain. The actual counter width can be trimmed via CWIDTH.  --
-- [WARNING] High and low words of counter output cnt_o are _NOT_ synchronized!     --
-- -------------------------------------------------------------------------------- --
-- The NEORV32 RISC-V Processor - https://github.com/stnolting/neorv32              --
-- Copyright (c) NEORV32 contributors.                                              --
-- Copyright (c) 2020 - 2026 Stephan Nolting. All rights reserved.                  --
-- Licensed under the BSD-3-Clause license, see LICENSE for details.                --
-- SPDX-License-Identifier: BSD-3-Clause                                            --
-- ================================================================================ --

library ieee;
use ieee.std_logic_1164.all;
use ieee.numeric_std.all;

entity neorv32_prim_cnt is
  generic (
    CWIDTH : natural range 0 to 64 -- actual counter width (0..64)
  );
  port (
    -- global control --
    clk_i  : in  std_ulogic;                     -- clock, rising edge
    rstn_i : in  std_ulogic;                     -- reset, low-active, async
    inc_i  : in  std_ulogic;                     -- enable counter increment
    -- read/write access --
    we_i   : in  std_ulogic_vector(1 downto 0);  -- subword write enable
    data_i : in  std_ulogic_vector(31 downto 0); -- subword write data
    oe_i   : in  std_ulogic;                     -- output enable
    cnt_o  : out std_ulogic_vector(63 downto 0)  -- trimmed counter output
  );
end entity;

architecture neorv32_prim_cnt_rtl of neorv32_prim_cnt is

  signal count : std_ulogic_vector(63 downto 0);
  signal carry, incen : std_ulogic_vector(0 downto 0);
  signal inc_lo, inc_hi : std_ulogic_vector(32 downto 0);

begin

  -- 64-Bit Counter (split across two 32-bit registers) -------------------------------------
  -- -------------------------------------------------------------------------------------------
  counter_core: process(rstn_i, clk_i)
  begin
    if (rstn_i = '0') then
      incen <= (others => '0');
      count <= (others => '0');
      carry <= (others => '0');
    elsif rising_edge(clk_i) then
      -- increment enable --
      incen(0) <= inc_i;
      -- low-word --
      if (we_i(0) = '1') then
        count(31 downto 0) <= data_i;
      else
        count(31 downto 0) <= inc_lo(31 downto 0);
      end if;
      -- low-to-high carry --
      carry(0) <= inc_lo(32);
      -- high-word --
      if (we_i(1) = '1') then
        count(63 downto 32) <= data_i;
      else
        count(63 downto 32) <= inc_hi(31 downto 0);
      end if;
    end if;
  end process;

  -- increments --
  inc_lo <= std_ulogic_vector(unsigned('0' & count(31 downto  0)) + unsigned(incen));
  inc_hi <= std_ulogic_vector(unsigned('0' & count(63 downto 32)) + unsigned(carry));

  -- Output Gating and Trimming -------------------------------------------------------------
  -- -------------------------------------------------------------------------------------------
  trim: process(oe_i, count)
  begin
    cnt_o <= (others => '0');
    if (oe_i = '1') and (CWIDTH > 0) then
      cnt_o(CWIDTH-1 downto 0) <= count(CWIDTH-1 downto 0);
    end if;
  end process;

end architecture;
