JeromeAntonyRobin/DOOM-on-GEMMrv32/rtl/system_integration/neorv32_litex_core_complex.vhd

-- ================================================================================ --
-- The NEORV32 RISC-V Processor - LiteX NEORV32 Core Complex Wrapper                --
-- -------------------------------------------------------------------------------- --
--                                __   _ __      _  __                              --
--                               / /  (_) /____ | |/_/                              --
--                              / /__/ / __/ -_)>  <                                --
--                             /____/_/\__/\__/_/|_|                                --
--                           Build your hardware, easily!                           --
--                                                                                  --
-- Unless otherwise noted, LiteX is copyright (C) 2012-2024 Enjoy-Digital.          --
-- All rights reserved.                                                             --
-- LiteX HQ: https://github.com/enjoy-digital/litex                                 --
-- -------------------------------------------------------------------------------- --
-- NEORV32 Core Complex wrapper for the LiteX SoC builder framework.                --
-- https://github.com/enjoy-digital/litex/tree/master/litex/soc/cores/cpu/neorv32   --
--                                                                                  --
-- This wrapper provides four pre-configured core complex configurations:           --
-- "minimal", "lite", "standard" and "full". See the 'configs_c' table for more     --
-- details which RISC-V ISA extensions and module parameters are used by each of    --
-- the these configurations. All configurations can be used with the                --
--  RISC-V-compatible on-chip debugger ("DEBUG").                                   --
-- -------------------------------------------------------------------------------- --
-- The NEORV32 RISC-V Processor - https://github.com/stnolting/neorv32              --
-- Copyright (c) NEORV32 contributors.                                              --
-- Copyright (c) 2020 - 2025 Stephan Nolting. All rights reserved.                  --
-- Licensed under the BSD-3-Clause license, see LICENSE for details.                --
-- SPDX-License-Identifier: BSD-3-Clause                                            --
-- ================================================================================ --

library ieee;
use ieee.std_logic_1164.all;

library neorv32;
use neorv32.neorv32_package.all;

entity neorv32_litex_core_complex is
  generic (
    CONFIG : natural; -- configuration select (0=minimal, 1=lite, 2=standard, 3=full)
    DEBUG  : boolean  -- enable on-chip debugger, valid for all configurations
  );
  port (
    -- Global control --
    clk_i      : in  std_ulogic; -- global clock, rising edge
    rstn_i     : in  std_ulogic; -- global reset, low-active, async

    -- JTAG on-chip debugger interface --
    jtag_tck_i : in  std_ulogic; -- serial clock
    jtag_tdi_i : in  std_ulogic; -- serial data input
    jtag_tdo_o : out std_ulogic; -- serial data output
    jtag_tms_i : in  std_ulogic; -- mode select

    -- External bus interface (Wishbone) --
    wb_adr_o   : out std_ulogic_vector(31 downto 0); -- address
    wb_dat_i   : in  std_ulogic_vector(31 downto 0); -- read data
    wb_dat_o   : out std_ulogic_vector(31 downto 0); -- write data
    wb_we_o    : out std_ulogic; -- read/write
    wb_sel_o   : out std_ulogic_vector(3 downto 0); -- byte enable
    wb_stb_o   : out std_ulogic; -- strobe
    wb_cyc_o   : out std_ulogic; -- valid cycle
    wb_ack_i   : in  std_ulogic; -- transfer acknowledge
    wb_err_i   : in  std_ulogic; -- transfer error

    -- CPU interrupt --
    irq_mei_i  : in  std_ulogic  -- RISC-V machine external interrupt (MEI)
  );
end entity;

architecture neorv32_litex_core_complex_rtl of neorv32_litex_core_complex is

  -- configuration helpers --
  constant num_configs_c : natural := 5;    -- number of pre-defined configurations
  type bool_t is array (num_configs_c-1 downto 0) of boolean;
  type natural_t is array (num_configs_c-1 downto 0) of natural;
  type configs_t is record
    riscv_c      : bool_t;
    riscv_m      : bool_t;
    riscv_u      : bool_t;
    riscv_a      : bool_t;
    dmem         : bool_t;
    imem         : bool_t;
    dcache       : bool_t;
    icache       : bool_t;
    riscv_zicntr : bool_t;
    riscv_zihpm  : bool_t;
    fast_ops     : bool_t;
    pmp_num      : natural_t;
    hpm_num      : natural_t;
    clint        : bool_t;
  end record;

  -- core complex configurations --
  constant configs_c : configs_t := (
    --               minimal   lite     standard full   numa
    riscv_c      => ( false,   true,    true,    true,  true  ), -- RISC-V compressed instructions 'C'
    riscv_m      => ( false,   true,    true,    true,  false ), -- RISC-V hardware mul/div 'M'
    riscv_u      => ( false,   false,   true,    true,  false ), -- RISC-V user mode 'U'
    riscv_a      => ( false,   false,   false,   false, true  ), -- RISC-V atomics
    dmem         => ( false,   false,   false,   false, true  ), -- enable data memory
    imem         => ( false,   false,   false,   false, false ), -- enable instruction memory
    dcache       => ( false,   false,   false,   true,  false ), -- enable data cache
    icache       => ( false,   false,   false,   true,  true  ), -- enable instruction cache
    riscv_zicntr => ( false,   false,   true,    true,  true  ), -- RISC-V standard CPU counters 'Zicntr'
    riscv_zihpm  => ( false,   false,   false,   true,  true  ), -- RISC-V hardware performance monitors 'Zihpm'
    fast_ops     => ( false,   false,   true,    true,  false ), -- use DSPs and barrel-shifters
    pmp_num      => ( 0,       0,       0,       8,     0     ), -- number of PMP regions (0..16)
    hpm_num      => ( 0,       0,       0,       8,     0     ), -- number of HPM counters (0..29)
    clint        => ( false,   true,    true,    true,  true  )  -- RISC-V core local interruptor
  );

begin

  -- NEORV32 Core Complex -------------------------------------------------------------------
  -- -------------------------------------------------------------------------------------------
  neorv32_core_complex: neorv32_top
  generic map (
    -- General --
    CLOCK_FREQUENCY       => 0,                              -- clock frequency of clk_i in Hz [not required by the core complex]
    BOOT_MODE_SELECT      => 1,
    BOOT_ADDR_CUSTOM      => x"00000000",
    -- On-Chip Debugger (OCD) --
    OCD_EN                => DEBUG,                          -- implement on-chip debugger
    -- RISC-V CPU Extensions --
    RISCV_ISA_C           => configs_c.riscv_c(CONFIG),      -- implement compressed extension?
    RISCV_ISA_M           => configs_c.riscv_m(CONFIG),      -- implement mul/div extension?
    RISCV_ISA_U           => configs_c.riscv_u(CONFIG),      -- implement user mode extension?
    RISCV_ISA_Zaamo       => configs_c.riscv_a(CONFIG),      -- implement atomics
    RISCV_ISA_Zalrsc      => configs_c.riscv_a(CONFIG),
    RISCV_ISA_Zicntr      => configs_c.riscv_zicntr(CONFIG), -- implement base counters?
    RISCV_ISA_Zihpm       => configs_c.riscv_zihpm(CONFIG),  -- implement hardware performance monitors?
    -- Tuning Options --
    CPU_FAST_MUL_EN       => configs_c.fast_ops(CONFIG),     -- use DSPs for M extension's multiplier
    CPU_FAST_SHIFT_EN     => configs_c.fast_ops(CONFIG),     -- use barrel shifter for shift operations
    -- Internal memories --
    DMEM_EN               => configs_c.dmem(CONFIG),
    IMEM_EN               => configs_c.imem(CONFIG),
    ICACHE_EN             => true, -- configs_c.icache(CONFIG) overridden
    ICACHE_NUM_BLOCKS     => 16,
    ICACHE_BLOCK_SIZE     => 128,
    DCACHE_EN             => true, -- configs_c.dcache(CONFIG) overridden
    DCACHE_NUM_BLOCKS     => 16,
    DCACHE_BLOCK_SIZE     => 128,
    IO_CFS_EN             => true,
    -- Physical Memory Protection (PMP) --
    PMP_NUM_REGIONS       => configs_c.pmp_num(CONFIG),      -- number of regions (0..16)
    PMP_MIN_GRANULARITY   => 4,                              -- minimal region granularity in bytes, has to be a power of 2, min 4 bytes
    -- Hardware Performance Monitors (HPM) --
    HPM_NUM_CNTS          => configs_c.hpm_num(CONFIG),      -- number of implemented HPM counters (0..29)
    HPM_CNT_WIDTH         => 64,                             -- total size of HPM counters (0..64)
    -- External bus interface (XBUS) --
    XBUS_EN               => true,                           -- implement external memory bus interface?
    XBUS_REGSTAGE_EN      => false,                          -- add XBUS register stage
    -- Processor peripherals --
    IO_CLINT_EN           => configs_c.clint(CONFIG)         -- implement core local interruptor (CLINT)?
  )
  port map (
    -- Global control --
    clk_i      => clk_i,      -- global clock, rising edge
    rstn_i     => rstn_i,     -- global reset, low-active, async
    -- JTAG on-chip debugger interface --
    jtag_tck_i => jtag_tck_i, -- serial clock
    jtag_tdi_i => jtag_tdi_i, -- serial data input
    jtag_tdo_o => jtag_tdo_o, -- serial data output
    jtag_tms_i => jtag_tms_i, -- mode select
    -- External bus interface --
    xbus_adr_o => wb_adr_o,   -- address
    xbus_dat_o => wb_dat_o,   -- write data
    xbus_we_o  => wb_we_o,    -- read/write
    xbus_sel_o => wb_sel_o,   -- byte enable
    xbus_stb_o => wb_stb_o,   -- strobe
    xbus_cyc_o => wb_cyc_o,   -- valid cycle
    xbus_dat_i => wb_dat_i,   -- read data
    xbus_ack_i => wb_ack_i,   -- transfer acknowledge
    xbus_err_i => wb_err_i,   -- transfer error
    -- CPU Interrupts --
    irq_mei_i  => irq_mei_i   -- machine external interrupt
  );

end architecture;
