JeromeAntonyRobin/DOOM-on-GEMMrv32/src/doom_palette_authentic.h

// Authentic Id Software DOOM 2 256-Color Palette (PLAYPAL Lump 0)
#ifndef DOOM_PALETTE_AUTHENTIC_H
#define DOOM_PALETTE_AUTHENTIC_H

#include <stdint.h>

static const uint16_t doom2_playpal_12bit[256] = {
    0x000, 0x110, 0x100, 0x444, 0xFFF, 0x111, 0x111, 0x000,
    0x000, 0x231, 0x220, 0x110, 0x010, 0x432, 0x432, 0x321,
    0xFBB, 0xFAA, 0xFAA, 0xE99, 0xE88, 0xD88, 0xD77, 0xD77,
    0xC66, 0xC66, 0xB55, 0xB55, 0xB44, 0xA44, 0xA33, 0xA33,
    0x933, 0x922, 0x822, 0x822, 0x811, 0x711, 0x711, 0x711,
    0x600, 0x600, 0x500, 0x500, 0x500, 0x400, 0x400, 0x400,
    0xFED, 0xFED, 0xFDC, 0xFDB, 0xFCB, 0xFCA, 0xFB9, 0xFB9,
    0xFB8, 0xFA7, 0xEA7, 0xE96, 0xD96, 0xD85, 0xC85, 0xC74,
    0xB74, 0xB74, 0xA64, 0xA63, 0x963, 0x853, 0x853, 0x752,
    0x742, 0x642, 0x542, 0x531, 0x431, 0x321, 0x321, 0x220,
    0xEEE, 0xEEE, 0xDDD, 0xDDD, 0xDDD, 0xCCC, 0xCCC, 0xBBB,
    0xBBB, 0xBBB, 0xAAA, 0xAAA, 0x999, 0x999, 0x999, 0x888,
    0x888, 0x777, 0x777, 0x666, 0x666, 0x666, 0x555, 0x555,
    0x444, 0x444, 0x444, 0x333, 0x333, 0x222, 0x222, 0x222,
    0x7F6, 0x6E6, 0x6D5, 0x5C5, 0x5B4, 0x5A4, 0x493, 0x493,
    0x382, 0x372, 0x262, 0x251, 0x141, 0x130, 0x120, 0x010,
    0xBA8, 0xB98, 0xA97, 0xA87, 0x986, 0x976, 0x976, 0x875,
    0x865, 0x764, 0x754, 0x654, 0x653, 0x543, 0x543, 0x532,
    0x986, 0x875, 0x864, 0x753, 0x653, 0x542, 0x432, 0x431,
    0x776, 0x675, 0x664, 0x564, 0x553, 0x443, 0x342, 0x332,
    0xFF7, 0xED5, 0xDB4, 0xC92, 0xA71, 0x951, 0x840, 0x720,
    0xFFF, 0xFDD, 0xFBB, 0xF99, 0xF77, 0xF55, 0xF33, 0xF11,
    0xF00, 0xE00, 0xE00, 0xD00, 0xC00, 0xB00, 0xB00, 0xA00,
    0x900, 0x800, 0x700, 0x700, 0x600, 0x500, 0x400, 0x400,
    0xEEF, 0xCCF, 0xAAF, 0x88F, 0x77F, 0x55F, 0x33F, 0x11F,
    0x00F, 0x00E, 0x00C, 0x00B, 0x009, 0x008, 0x006, 0x005,
    0xFFF, 0xFED, 0xFDB, 0xFC9, 0xFB7, 0xFA5, 0xF83, 0xF71,
    0xF71, 0xE60, 0xD60, 0xD50, 0xC50, 0xC40, 0xB40, 0xA40,
    0xFFF, 0xFFD, 0xFFB, 0xFF8, 0xFF6, 0xFF4, 0xFF2, 0xFF0,
    0xA30, 0x930, 0x920, 0x820, 0x432, 0x421, 0x321, 0x210,
    0x005, 0x004, 0x003, 0x002, 0x002, 0x001, 0x000, 0x000,
    0xF94, 0xFE4, 0xF7F, 0xF0F, 0xC0C, 0x909, 0x606, 0xA66,
};

#endif // DOOM_PALETTE_AUTHENTIC_H
