JeromeAntonyRobin/DOOM-on-GEMMrv32/(commit log)

2026-10-14 Fix bootloader UART stream sync: flush RX FIFO, skip leading CR/LF on upload, recover from upload error instead of halting
2026-10-14 Update HARDWARE_DEBUG_REPORT.md with bootloader UART stream synchronization fix
2026-10-14 Add 64-byte UART0 FIFOs, disable interrupts during bootloader streaming, and update bootrom image
2026-10-14 docs: document PROG button vs btnC reset and JP1 mode jumper for USB keyboard HID support
2026-10-14 feat: Basys 3 SoC integration, tracked bitstream, pure TCL flow, and docs organization
2026-10-15 eliminated frame retention and buffer stalls with non-blocking input and backdrop rasterization
2026-10-17 docs: add comprehensive architecture, driver, and engineering master manual
